namrolyat/Gamecontroller/PCB_Gamecontroller_Teensy.jpg

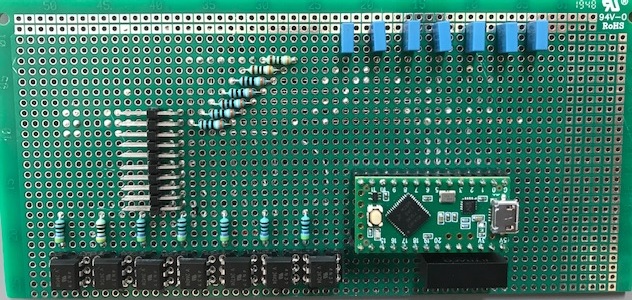
PCB_Gamecontroller_Teensy.jpg
