namrolyat/Gamecontroller/PCB_Gamecontroller.jpg

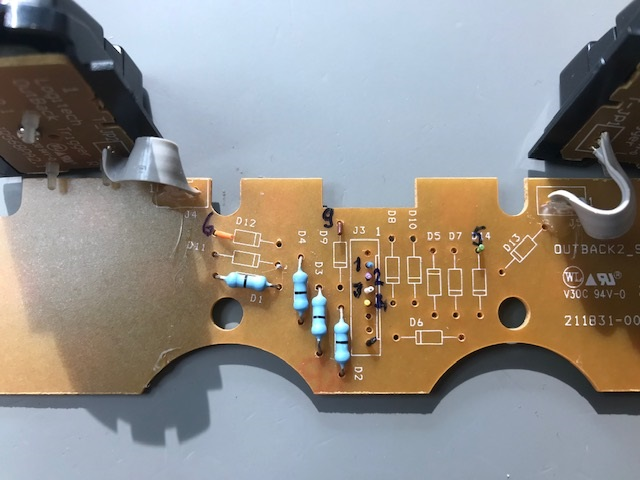
PCB_Gamecontroller.jpg
