namrolyat/Gamecontroller/README.md

# Gamecontroller
Gamecontroller with Teensy LC en Arduino Leonardo.
To sent 7 different CHAR to the PC like a keyboard HID.
Example Q,W,E,R,T,Y  or 1234567 enz....
For the second time!!
