namrolyat/Gamecontroller/DiagramGameController.pdf

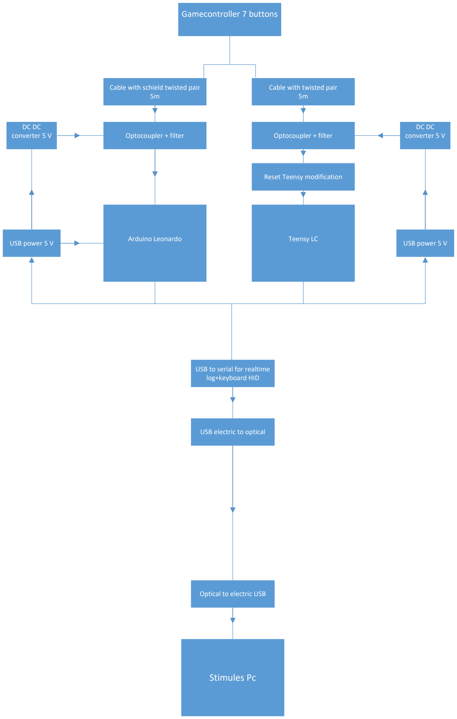
[picture p8: figure]
Stimules Pc; Cable with schield twisted pair 5m; Gamecontroller 7 buttons; Cable with twisted pair 5m; Arduino Leonardo; Optocoupler + filter; DC DC converter 5 V; USB power 5 V; USB to serial for realtime log+keyboard HID; USB electric to optical; Optical to electric USB; Teensy LC; Reset Teensy modification
