namrolyat/Gamecontroller/gamecontroller_Teensy__1.3.brd

## EAGLE design gamecontroller_Teensy__1.3.brd (2020-10-09)

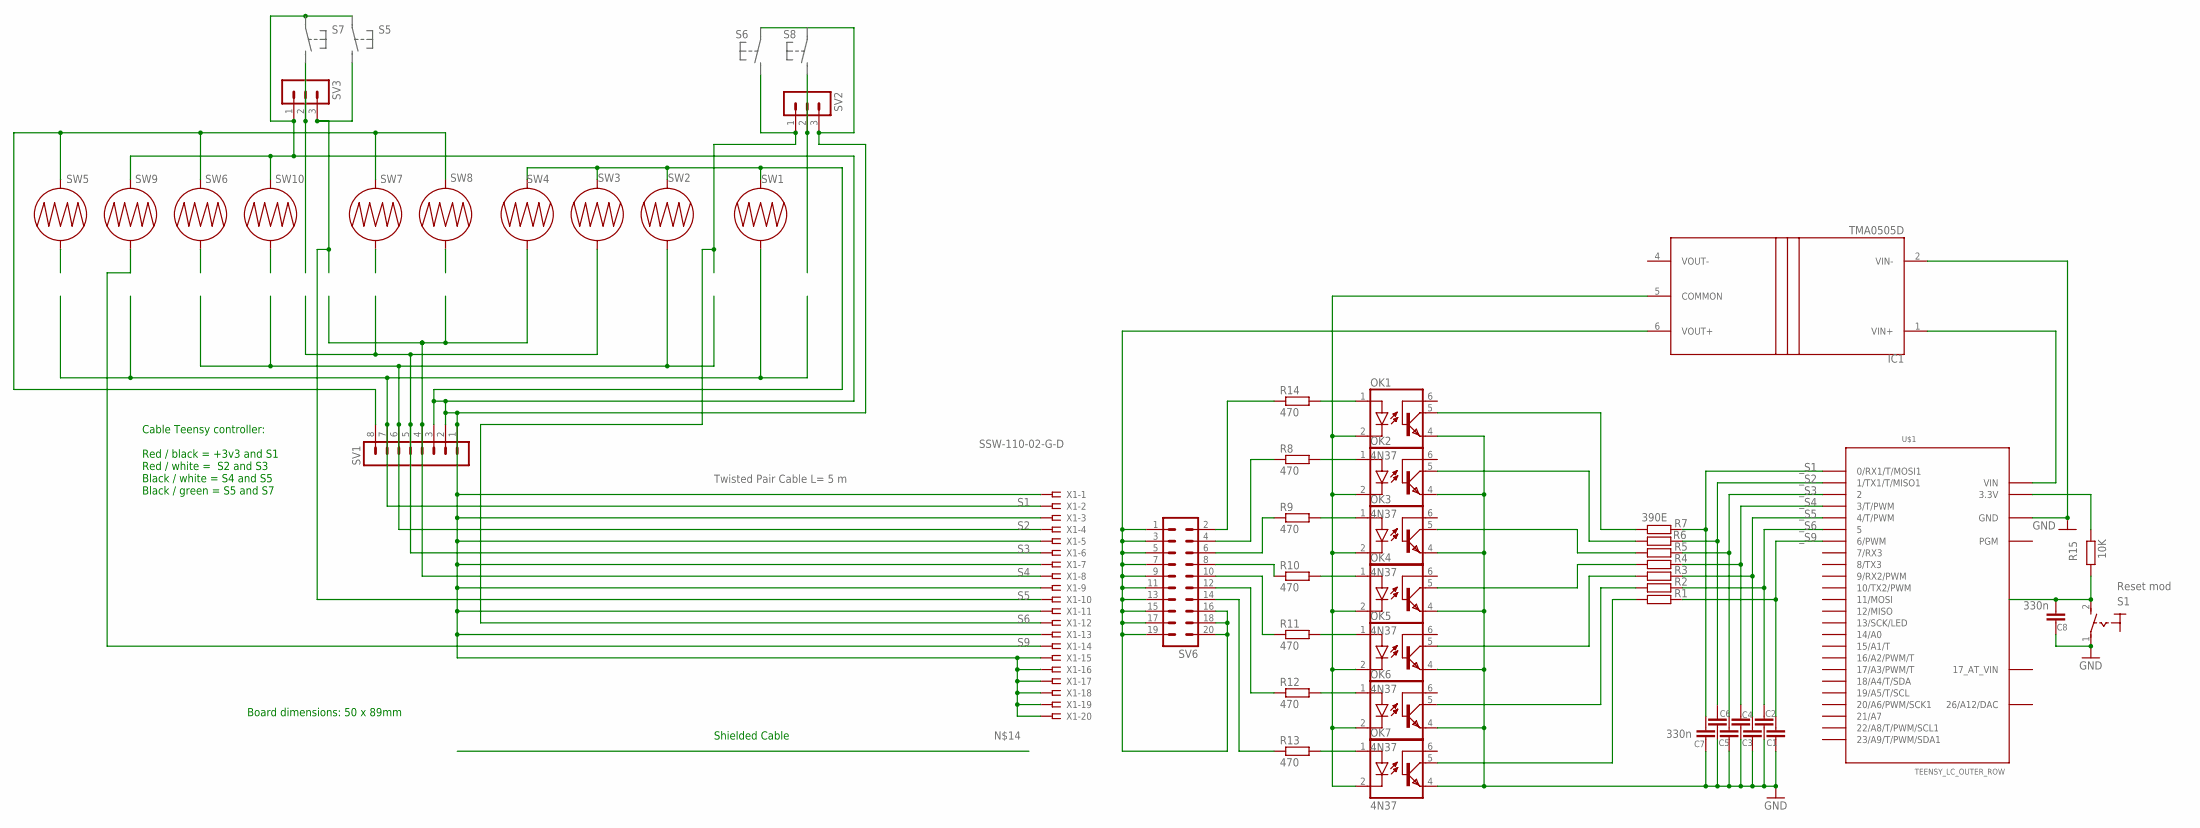
[picture p9: schematic gamecontroller_Teensy__1.3.sch]

Parts:
C1, C2, C3, C4, C5, C6: C-EU025-025X050; C025-025X050
C7, C8: 330n; C025-025X050
IC1: TMA0505D; SIP7
OK1, OK2, OK3, OK4, OK5, OK6, OK7: 4N37; DIL06
R1, R2, R3, R4, R5, R6: R-EU_0204/5; 0204/5
R7: 390E; 0204/5
R8, R9, R10, R11, R12, R13, R14: 470; 0204/5
R15: 10K; 0204/5
S1: Reset mod; MS243
SV1: MA08-1
SV2, SV3: MA03-1
SV6: MA10-2W
SW1, SW2, SW3, SW4, SW5, SW6, SW7, SW8, SW9, SW10: BUTTON-CONDUCTIVESMD-0.1"; BUTTON-CONDUCTIVE-0.1
U$1: TEENSY_LC_OUTER_ROW; TEENSY_3.0-3.2&LC_OUTER_ROW
X1: SSW-110-02-G-D

Connections:
26/A12/DAC: U$1.RESET/DAC (26/A12/DAC)
COMMON: SV1.1, SV1.2, SV1.3, SV2.3, SV3.1, SW1.2, SW2.2, SW3.2, SW4.2, SW9.1, SW10.1, X1.1, X1.3, X1.5, X1.7, X1.9, X1.11, X1.13, X1.15, X1.16, X1.17, X1.18, X1.19, X1.20
GND: C1.2, C2.2, C3.2, C4.2, C5.2, C6.2, C7.2, C8.2, IC1.2 (VIN-), OK1.4 (EMI), OK2.4 (EMI), OK3.4 (EMI), OK4.4 (EMI), OK5.4 (EMI), OK6.4 (EMI), OK7.4 (EMI), S1.1, U$1.AGND (GND), U$1.GND, U$1.GND1 (GND)
unnamed: R8.1, SV6.4
unnamed: OK1.1 (A), R14.2
unnamed: SV1.8, SW5.1, SW6.1, SW7.1, SW8.1
unnamed: R14.1, SV6.2
unnamed: IC1.6 (VOUT+), SV6.1, SV6.3, SV6.5, SV6.7, SV6.9, SV6.11, SV6.13, SV6.15, SV6.16, SV6.17, SV6.18, SV6.19, SV6.20
unnamed: OK1.5 (COL), R7.1
unnamed: R9.1, SV6.6
unnamed: R10.1, SV6.8
unnamed: R11.1, SV6.10
unnamed: R12.1, SV6.12
unnamed: OK2.5 (COL), R6.1
unnamed: OK3.5 (COL), R5.1
unnamed: OK4.5 (COL), R4.1
unnamed: OK5.5 (COL), R3.1
unnamed: OK6.5 (COL), R2.1
unnamed: OK7.5 (COL), R1.1
unnamed: OK2.1 (A), R8.2
unnamed: OK3.1 (A), R9.2
unnamed: OK4.1 (A), R10.2
unnamed: C8.1, R15.1, S1.2 (S)
unnamed: R13.1, SV6.14
unnamed: OK7.1 (A), R13.2
unnamed: OK6.1 (A), R12.2
unnamed: OK5.1 (A), R11.2
unnamed: IC1.1 (VIN+), U$1.VIN
unnamed: R15.2, U$1.3.3V, U$1.3.3V1 (3.3V)
unnamed: IC1.5 (COMMON), OK1.2 (C), OK2.2 (C), OK3.2 (C), OK4.2 (C), OK5.2 (C), OK6.2 (C), OK7.2 (C)
S1: SV1.7, SW1.1, X1.2
S2: SV1.6, SW2.1, X1.4
S3: SV1.5, SW3.1, X1.6
S4: SV1.4, SW4.1, X1.8
S5: SV3.3, X1.10
S6: SV2.1, X1.12
S9: SW9.2, X1.14
VOUT-: IC1.4 (VOUT-)
_S1: C7.1, R7.2, U$1.0 (0/RX1/T/MOSI1)
_S2: C6.1, R6.2, U$1.1 (1/TX1/T/MISO1)
_S3: C5.1, R5.2, U$1.2
_S4: C4.1, R4.2, U$1.3 (3/T/PWM)
_S5: C3.1, R3.2, U$1.4 (4/T/PWM)
_S6: C2.1, R2.2, U$1.5
_S9: C1.1, R1.2, U$1.6 (6/PWM)

Notes on the sheet:
Board dimensions: 50 x 89mm
Shielded Cable
Twisted Pair Cable L= 5 m
Cable Teensy controller: Red / black = +3v3 and S1 Red / white = S2 and S3 Black / white = S4 and S5 Black / green = S5 and S7

Board: 2 copper layers, 48 parts (0 on the bottom side), 43 nets, no tracks yet.
