namrolyat/Gamecontroller/(commit log)

2020-10-08 Update README.md
    Arduino leonardo toegevoegd
2020-10-08 Add files via upload
    Arduino file geupload van bedcontroller
2020-10-09 info toegevoegd
    info over het doel van de controllers toegevoegd.
2020-10-09 Add files via upload
    Arduino file for the Leonardo or Micro.
2020-10-09 Add files via upload
    Code for the Teensy LC
2020-10-09 Add files via upload
    Picture of the PCB.
2020-10-09 Add files via upload
    Picture off the game controller PCB.
2020-10-09 Add files via upload
    Eagle schematics.
    [gamecontroller_Arduino_1.3.brd, gamecontroller_Arduino_1.3.sch, gamecontroller_Teensy__1.3.brd, gamecontroller_Teensy__1.3.sch]
